atb033/ecn_desro_project/README.md

# ecn_desro_project

The aim of this project was to create an optimal Schoenflies motion generation. 

A 4-RUU parallel manipulator was chosen for this task. This code performs the dimensioning of the manipulator. For more info please go through the project report (4ruu_report.pdf)

Video: https://www.youtube.com/watch?v=EMqjkbBu76A
