atb033/ecn_desro_project/CAD_4RUU/4ruu_assy.SLDASM

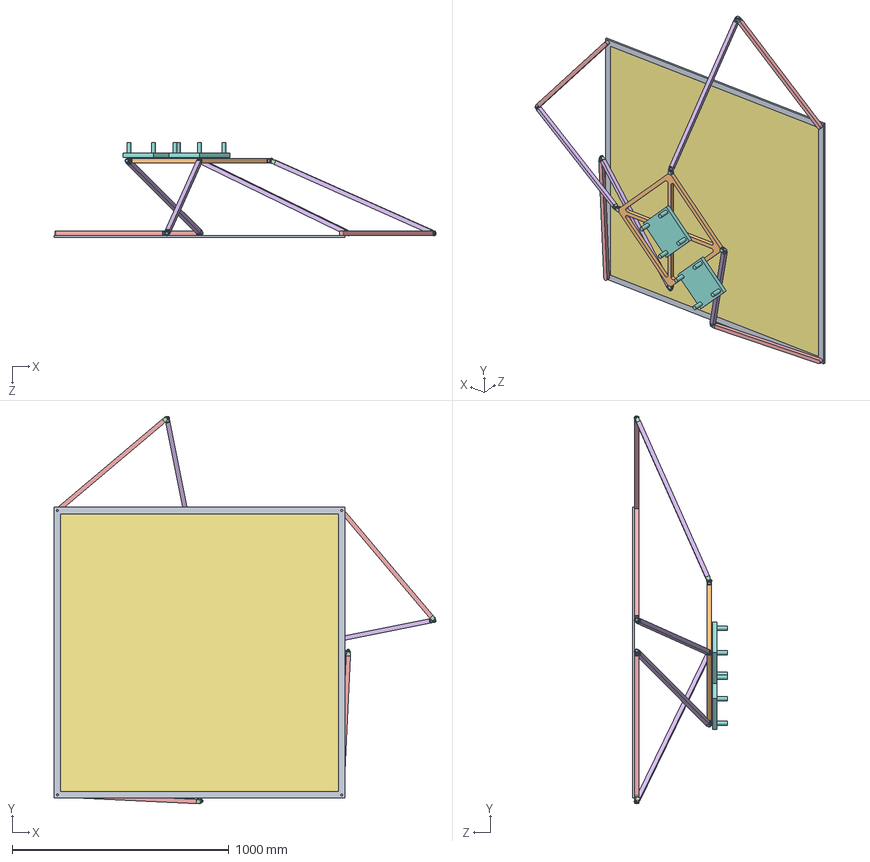
[picture p9: CAD file, 2018-07-07]
CAD_4RUU/4ruu_assy.SLDASM
1763.1 x 1788.9 x 440.0 mm
base_platform
moving_platform_v2
connector_new x 8
U_leg x 16
active_link x 4
passive_link x 4
base_glass
stand x 2
