atb033/ecn_desro_project/CAD_4RUU/leg_assy.SLDASM

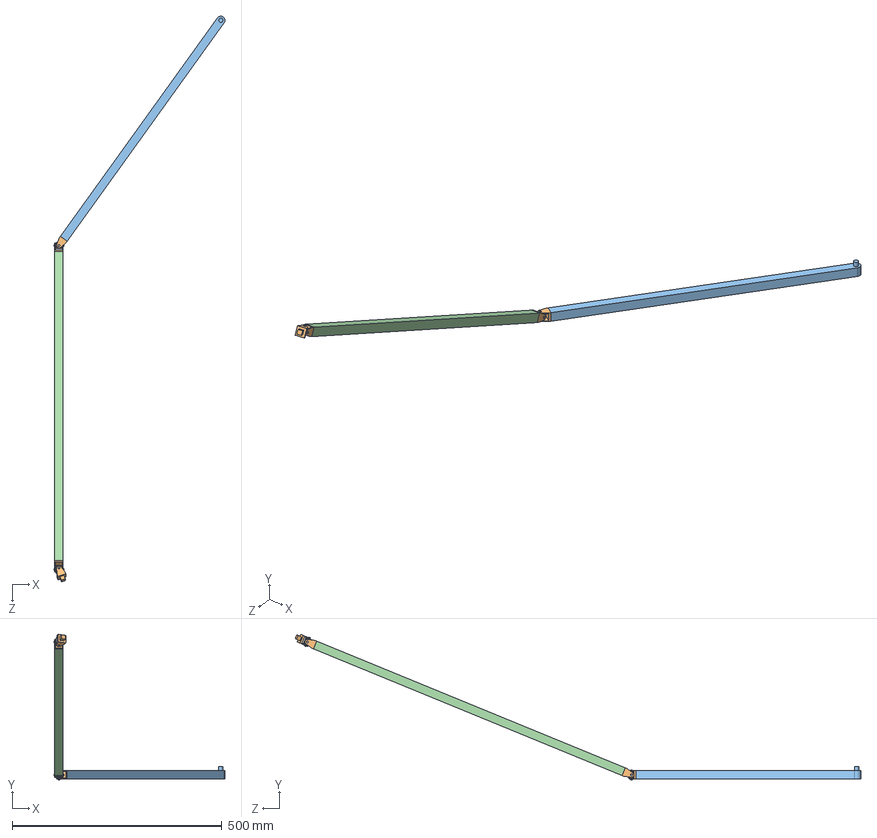
[picture p10: CAD file, 2018-07-07]
CAD_4RUU/leg_assy.SLDASM
408.0 x 347.5 x 1350.1 mm
connector_new x 2
U_leg x 4
active_link
passive_link
