atb033/ecn_desro_project/CAD_4RUU/U_assy.SLDASM

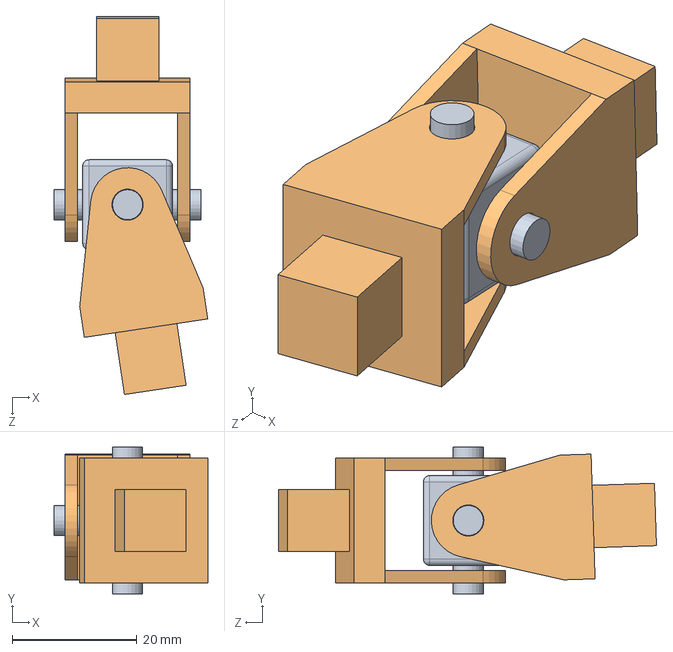
[picture p11: CAD file, 2018-07-07]
CAD_4RUU/U_assy.SLDASM
24.6 x 23.5 x 60.6 mm
connector_new
U_leg x 2
