atb033/ecn_desro_project/CAD_4RUU/U_leg.SLDPRT

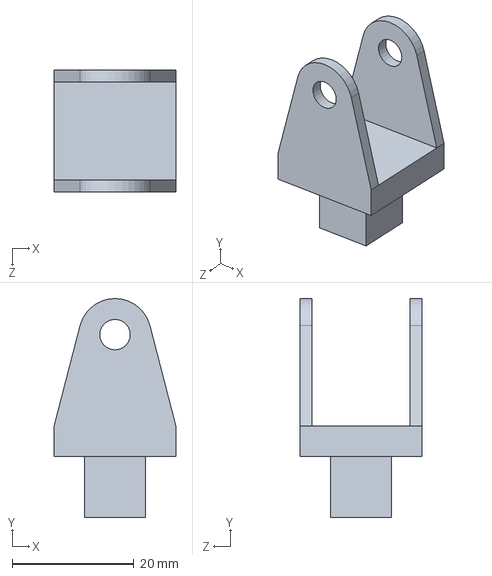
[picture p12: CAD file, 2018-07-07]
CAD_4RUU/U_leg.SLDPRT
20.0 x 35.9 x 20.0 mm
