atb033/ecn_desro_project/CAD_4RUU/passive_link.SLDPRT

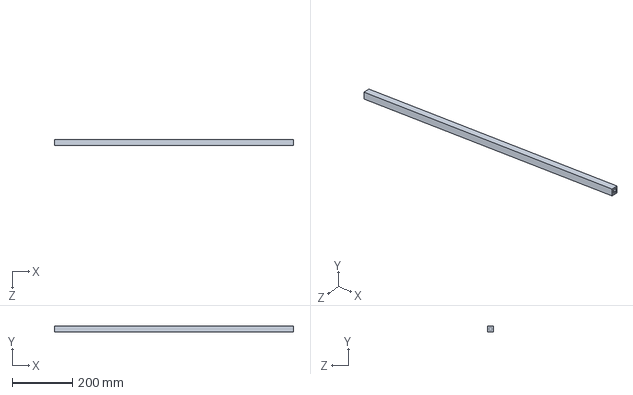
[picture p13: CAD file, 2018-07-07]
CAD_4RUU/passive_link.SLDPRT
796.0 x 20.0 x 20.0 mm
