atb033/ecn_desro_project/CAD_4RUU/moving_platform_v2.SLDPRT

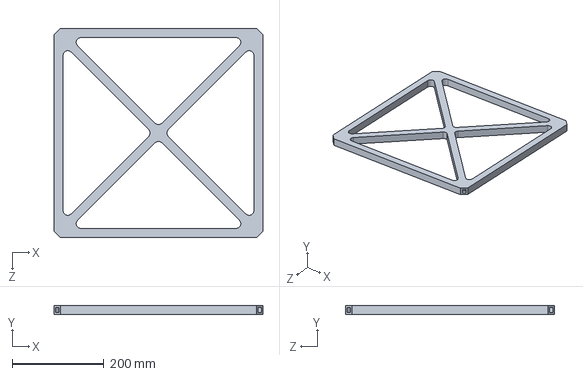
[picture p14: CAD file, 2018-07-07]
CAD_4RUU/moving_platform_v2.SLDPRT
455.4 x 20.0 x 455.4 mm
