atb033/ecn_desro_project/CAD_4RUU/base_platform.SLDPRT

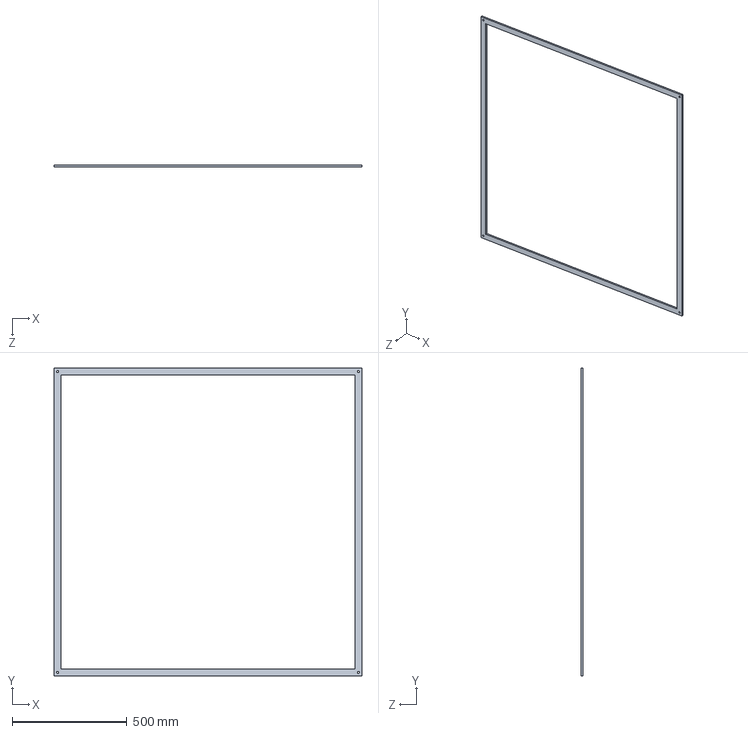
[picture p15: CAD file, 2018-07-07]
CAD_4RUU/base_platform.SLDPRT
1343.5 x 1343.5 x 10.0 mm
