atb033/ecn_desro_project/CAD_4RUU/connector_new.SLDPRT

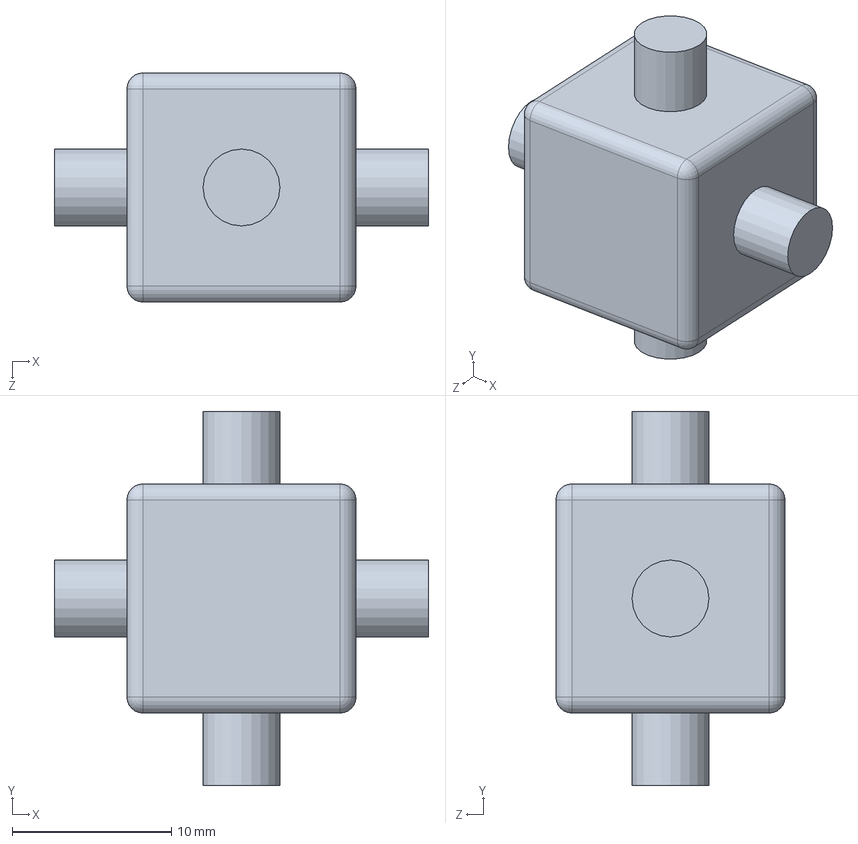
[picture p16: CAD file, 2018-07-07]
CAD_4RUU/connector_new.SLDPRT
23.5 x 23.5 x 14.4 mm
