atb033/ecn_desro_project/CAD_4RUU/base_glass.SLDPRT

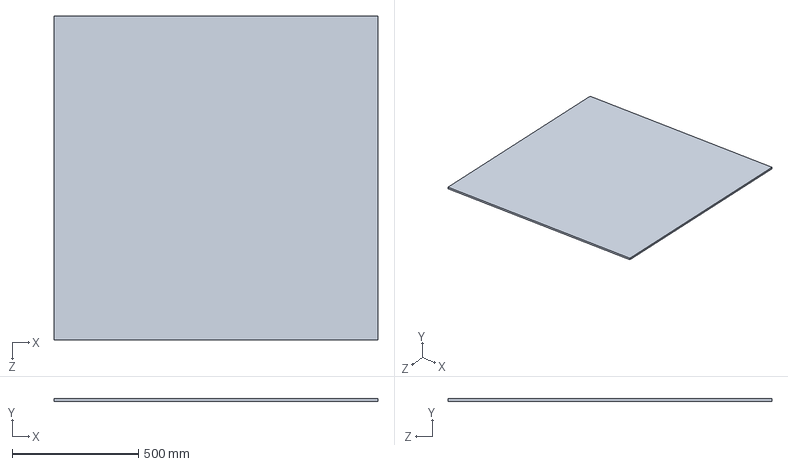
[picture p17: CAD file, 2018-07-07]
CAD_4RUU/base_glass.SLDPRT
1281.3 x 10.0 x 1281.3 mm
