atb033/ecn_desro_project/CAD_4RUU/stand.SLDPRT

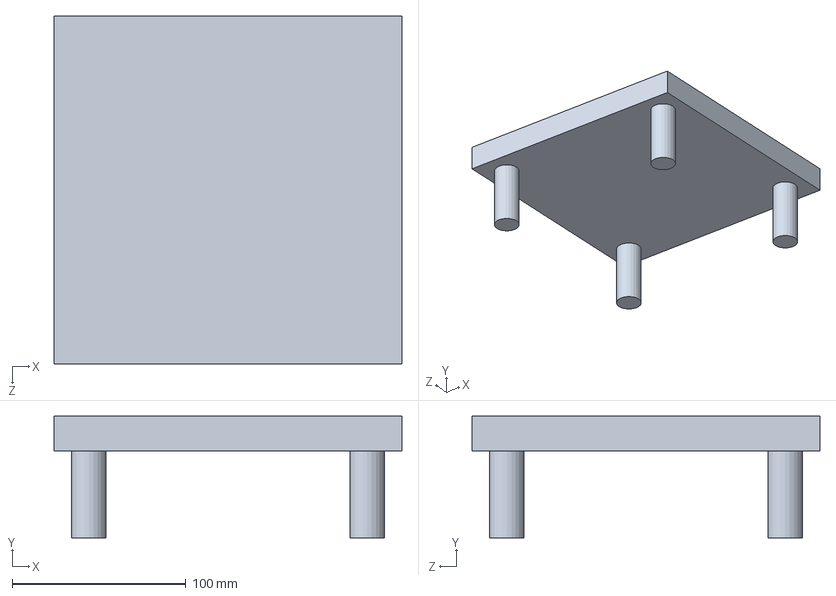
[picture p18: CAD file, 2018-07-07]
CAD_4RUU/stand.SLDPRT
200.0 x 70.0 x 200.0 mm
