atb033/ecn_desro_project/CAD_4RUU/active_link.SLDPRT

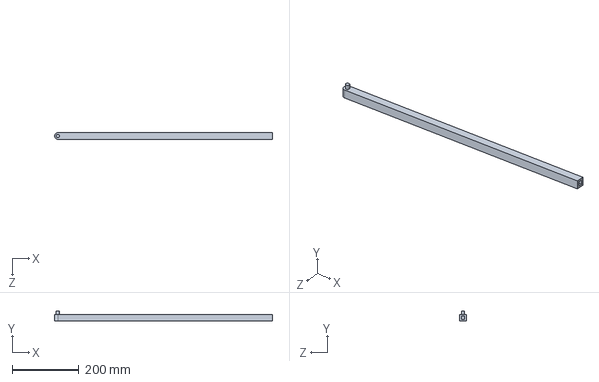
[picture p19: CAD file, 2018-07-07]
CAD_4RUU/active_link.SLDPRT
652.0 x 30.0 x 20.0 mm
